vikurva/SkinBot/Mechanical/CAD Robot V1/suction_cup_vertical_v8_rotator_assembly.SLDASM

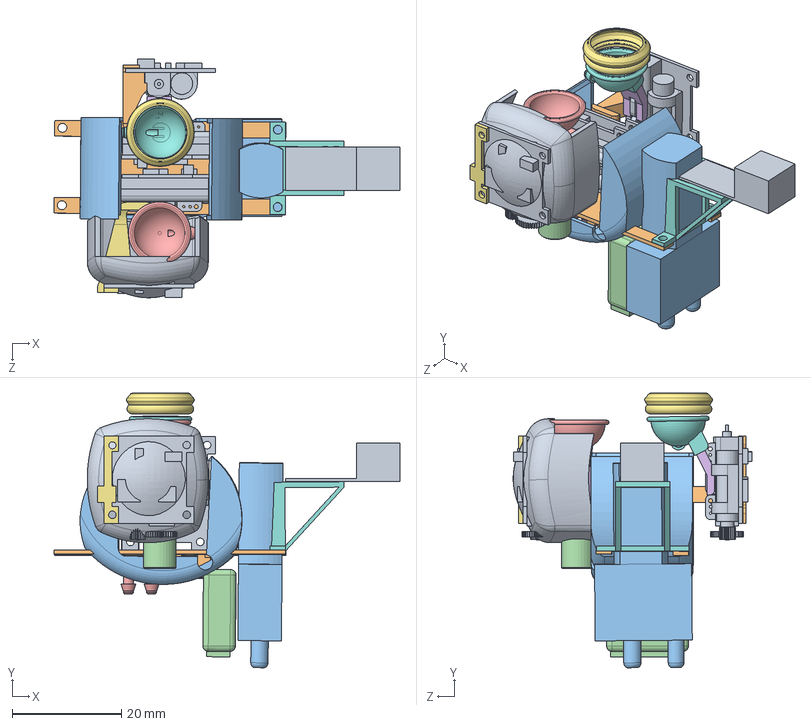
[picture p1: CAD file, 2018-07-06]
Mechanical/CAD Robot V1/suction_cup_vertical_v8_rotator_assembly.SLDASM
63.4 x 50.3 x 43.7 mm
1_8grams_linear_servo x 4
servo_suction_cup_arm_right_v6
silicone_hoses_holder_v2
suction_cap_arm_v1
suction_cap_v1
PCB_SkinBot_tethered_v1
TGPP06-D-136
suction_cap_v1_for_motor_0_5_offset
motor_connector_v1
servo_suction_cup_arm_left_v6_motor
