vikurva/SkinBot/Electrical/tetherRobot_board/PCB_skinBot_tether_wire_board_v1.step

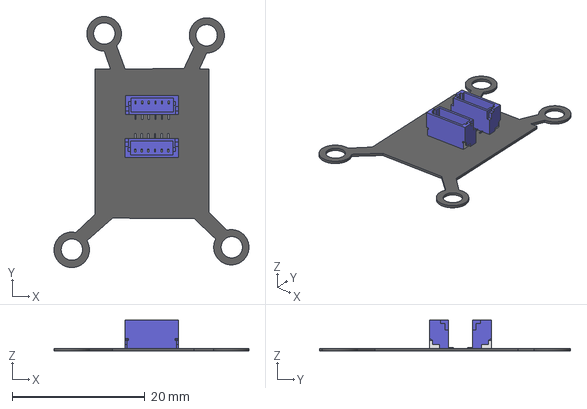
[picture p2: CAD file, 2018-07-12]
Electrical/tetherRobot_board/PCB_skinBot_tether_wire_board_v1.step
29.3 x 37.8 x 4.66 mm
