vikurva/SkinBot/Mechanical/CAD Robot V1/all parts 3D print V1/suction_cap_arm_v1.STL

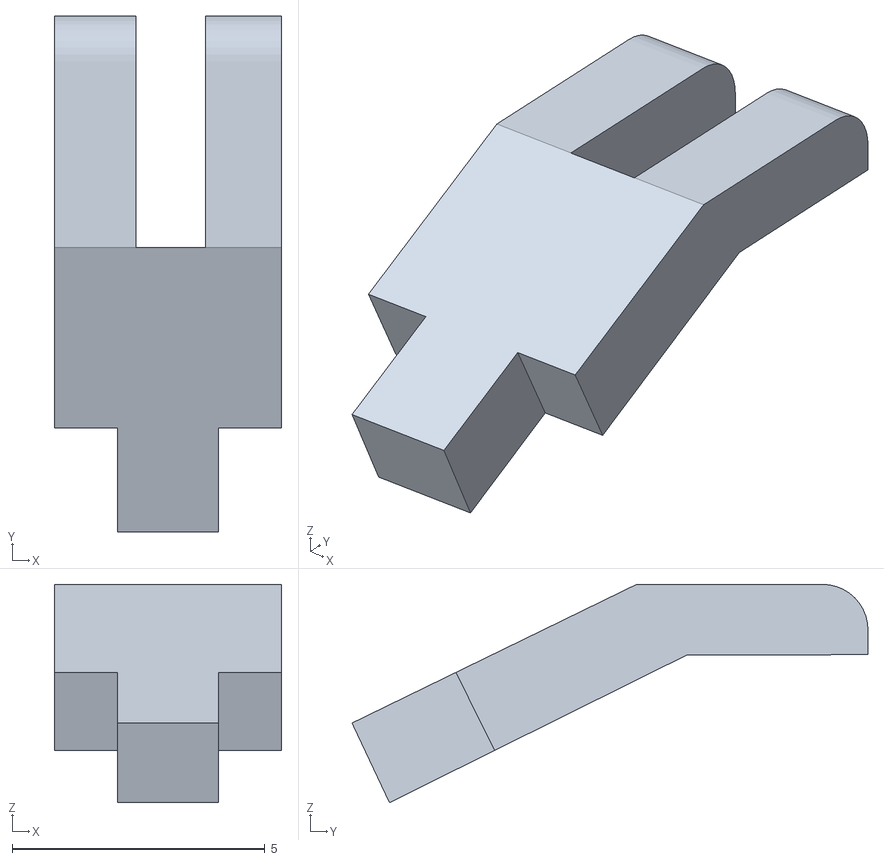
[picture p3: CAD file, 2018-07-06]
Mechanical/CAD Robot V1/all parts 3D print V1/suction_cap_arm_v1.STL
4.50 x 10.2 x 4.32
