vikurva/SkinBot/Mechanical/CAD Robot V1/nozzle_adapter_v1.SLDPRT

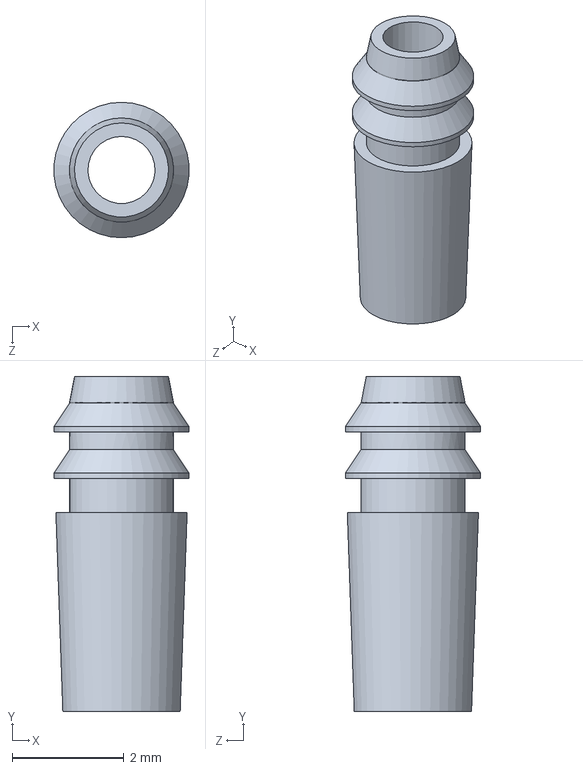
[picture p4: CAD file, 2018-07-06]
Mechanical/CAD Robot V1/nozzle_adapter_v1.SLDPRT
2.41 x 5.99 x 2.42 mm
