vikurva/SkinBot/Mechanical/CAD Robot V1/all parts 3D print V1/servo_suction_cup_arm_right_v6.STL

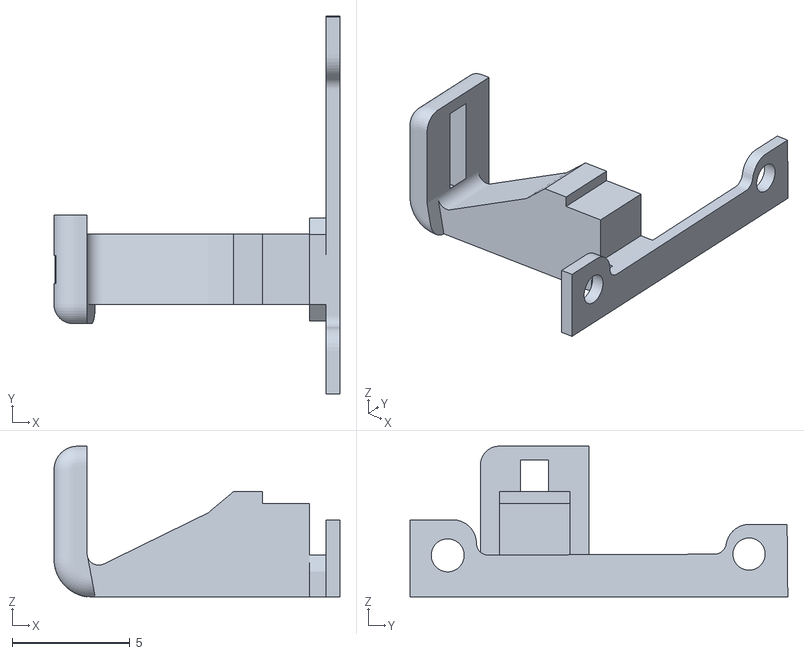
[picture p5: CAD file, 2018-07-06]
Mechanical/CAD Robot V1/all parts 3D print V1/servo_suction_cup_arm_right_v6.STL
12.1 x 16.0 x 6.40
