vikurva/SkinBot/Mechanical/CAD Robot V1/suction_cap_v1.SLDPRT

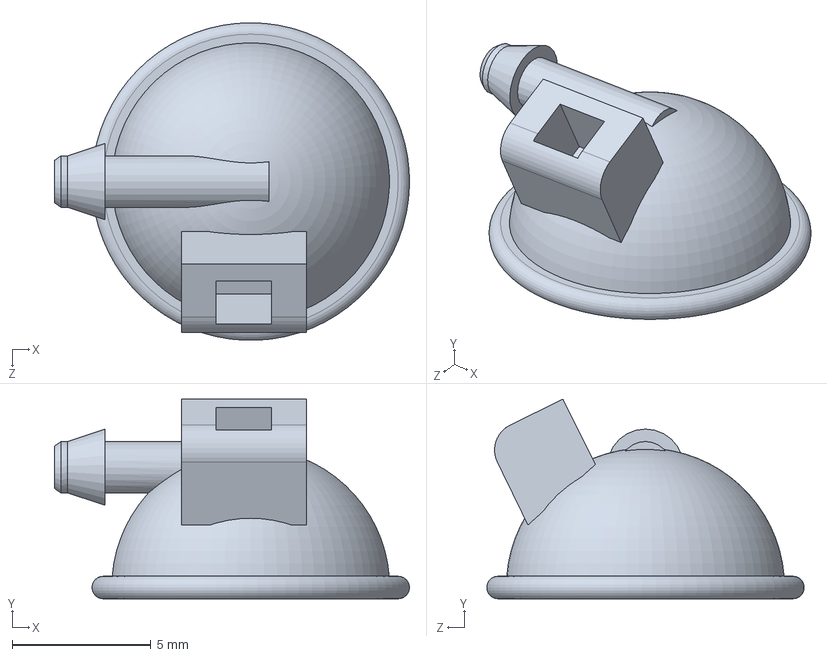
[picture p6: CAD file, 2018-07-06]
Mechanical/CAD Robot V1/suction_cap_v1.SLDPRT
12.8 x 7.19 x 11.4 mm
