vikurva/SkinBot/Mechanical/CAD Robot V1/all parts 3D print V1/servo_suction_cup_arm_left_v6_motor.STL

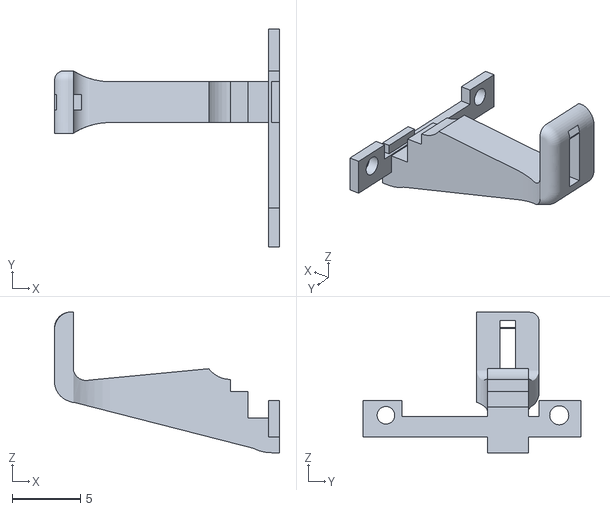
[picture p7: CAD file, 2018-07-06]
Mechanical/CAD Robot V1/all parts 3D print V1/servo_suction_cup_arm_left_v6_motor.STL
16.5 x 16.0 x 10.3
