vikurva/SkinBot/Mechanical/CAD Robot V1/rubber_sleeve_v1.SLDPRT

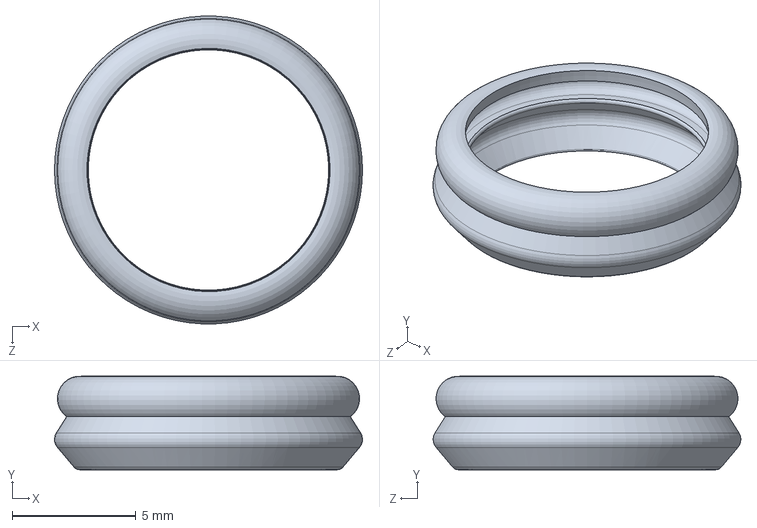
[picture p8: CAD file, 2018-07-06]
Mechanical/CAD Robot V1/rubber_sleeve_v1.SLDPRT
12.5 x 3.78 x 12.4 mm
