vikurva/SkinBot/Mechanical/CAD Robot V1/all parts 3D print V1/suction_cap_v1_for_motor_0_5_offset.STL

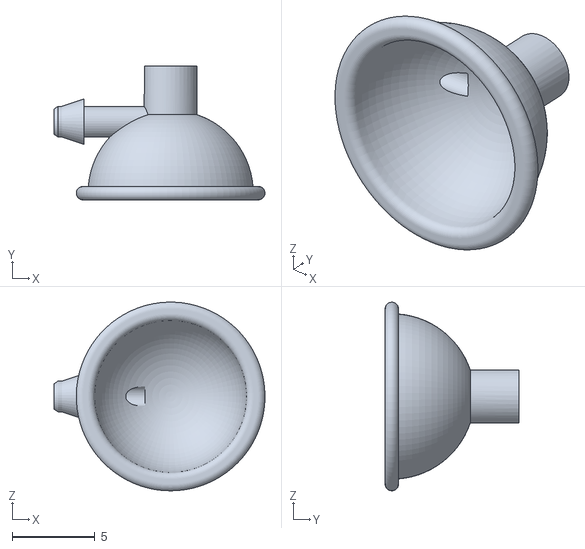
[picture p9: CAD file, 2018-07-06]
Mechanical/CAD Robot V1/all parts 3D print V1/suction_cap_v1_for_motor_0_5_offset.STL
12.8 x 8.11 x 11.4
