vikurva/SkinBot/Mechanical/CAD Robot V1/servo_suction_cup_holder_v1.SLDPRT

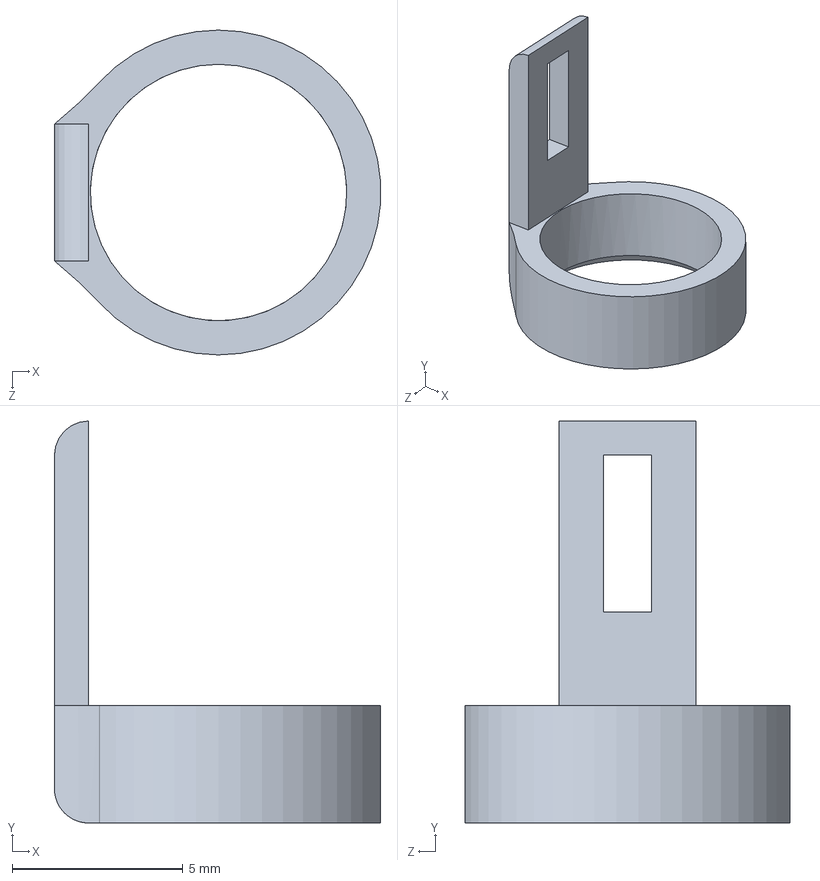
[picture p10: CAD file, 2018-07-06]
Mechanical/CAD Robot V1/servo_suction_cup_holder_v1.SLDPRT
9.54 x 11.8 x 9.50 mm
