vikurva/SkinBot/Mechanical/CAD Robot V1/all parts 3D print V1/silicone_hoses_holder_v2.STL

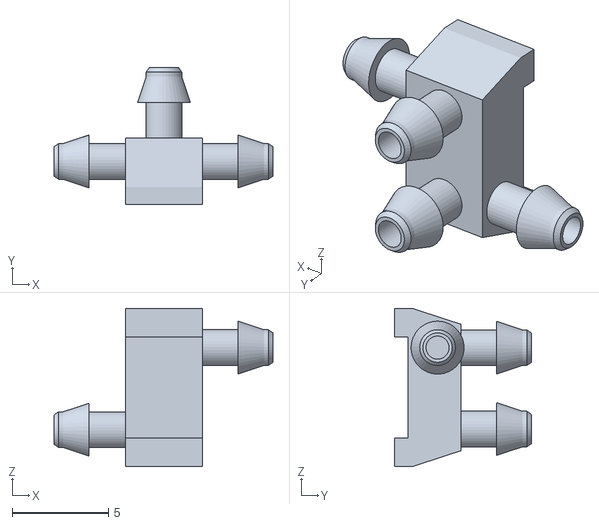
[picture p11: CAD file, 2018-07-06]
Mechanical/CAD Robot V1/all parts 3D print V1/silicone_hoses_holder_v2.STL
11.4 x 7.12 x 8.25
