vikurva/SkinBot/Mechanical/CAD Robot V1/PCB_SkinBot_tethered_v1.SLDPRT

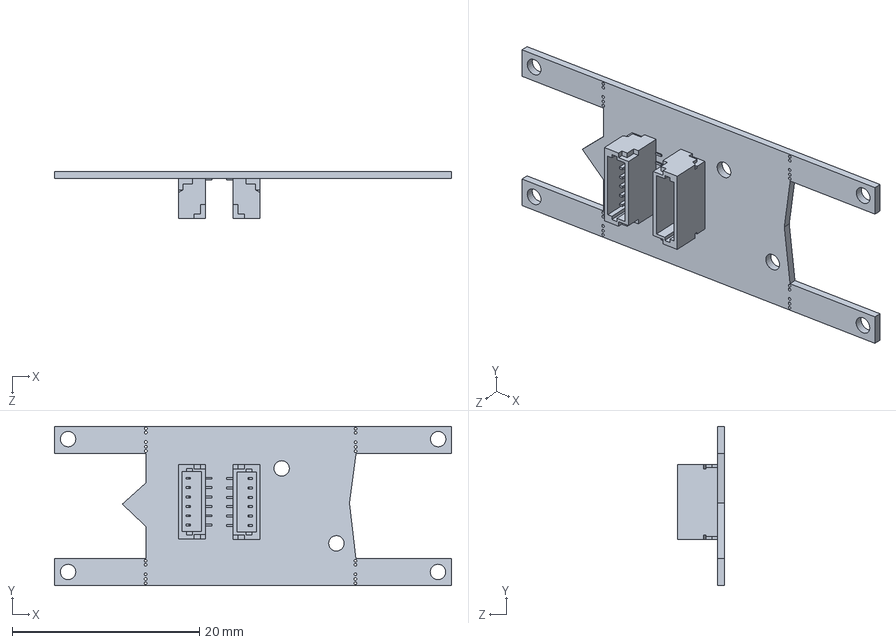
[picture p12: CAD file, 2018-07-06]
Mechanical/CAD Robot V1/PCB_SkinBot_tethered_v1.SLDPRT
42.4 x 17.0 x 5.02 mm
