vikurva/SkinBot/Mechanical/CAD Robot V1/motor_connector_v1.SLDPRT

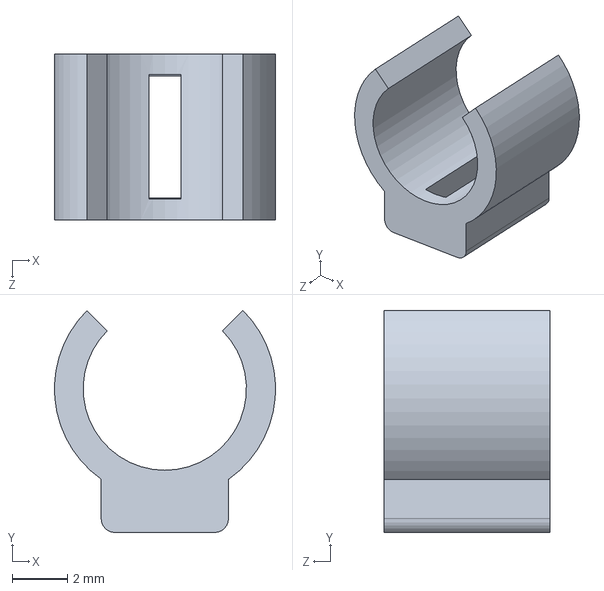
[picture p13: CAD file, 2018-07-06]
Mechanical/CAD Robot V1/motor_connector_v1.SLDPRT
7.99 x 8.03 x 6.00 mm
