vikurva/SkinBot/Mechanical/CAD Robot V1/camera_mount_v1.SLDPRT

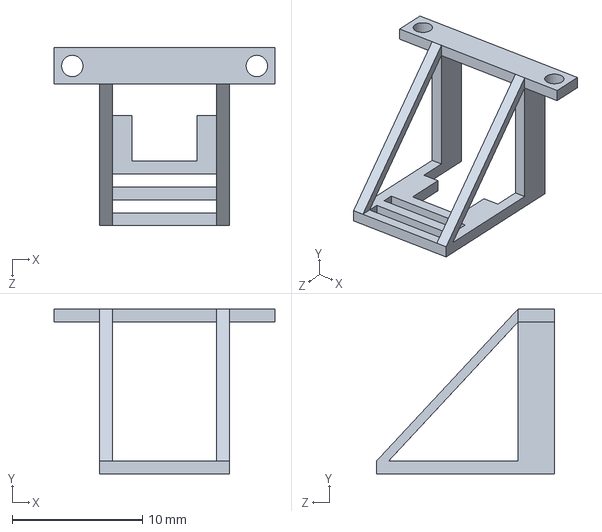
[picture p14: CAD file, 2018-07-06]
Mechanical/CAD Robot V1/camera_mount_v1.SLDPRT
17.0 x 12.6 x 13.7 mm
