vikurva/SkinBot/Mechanical/CAD Robot V1/small_DC_pumP_30kPa.SLDPRT

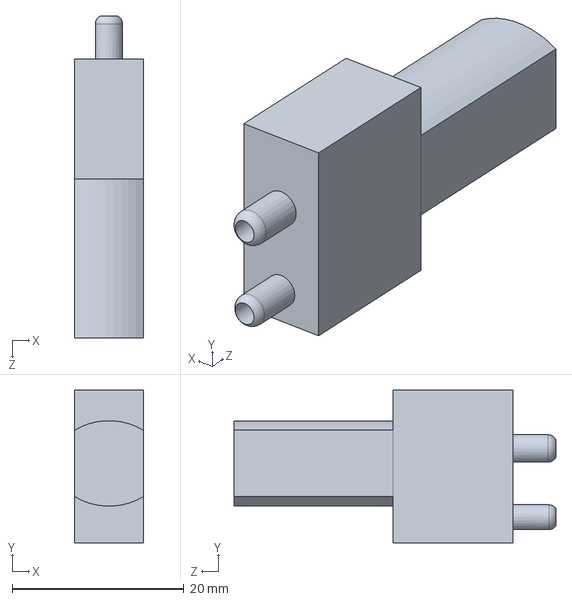
[picture p15: CAD file, 2018-07-06]
Mechanical/CAD Robot V1/small_DC_pumP_30kPa.SLDPRT
8.00 x 17.8 x 37.5 mm
