vikurva/SkinBot/Mechanical/CAD Robot V1/silicone_hoses_holder_v2_inverse.SLDPRT

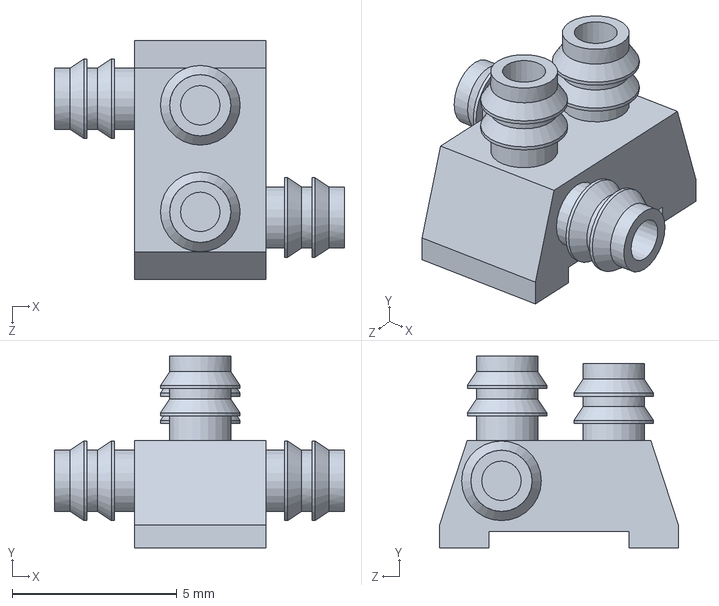
[picture p16: CAD file, 2018-07-06]
Mechanical/CAD Robot V1/silicone_hoses_holder_v2_inverse.SLDPRT
8.80 x 5.82 x 7.25 mm
