vikurva/SkinBot/Mechanical/CAD Robot V1/TGPP06-D-136.SLDPRT

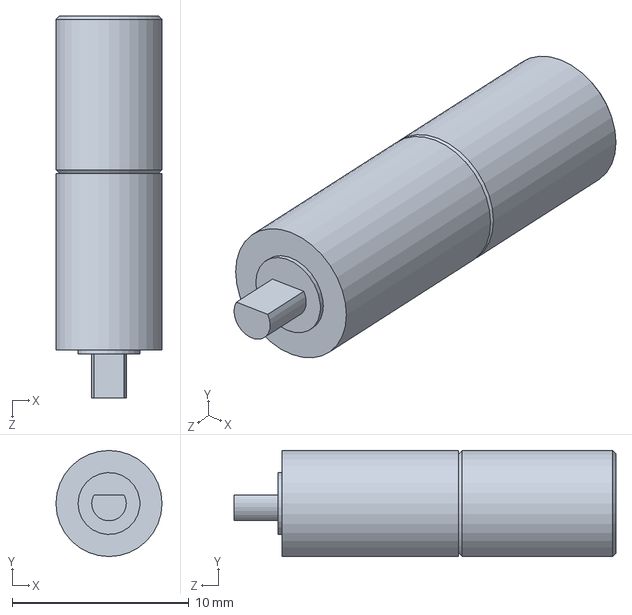
[picture p17: CAD file, 2018-07-06]
Mechanical/CAD Robot V1/TGPP06-D-136.SLDPRT
6.00 x 6.00 x 21.6 mm
