vikurva/SkinBot/Mechanical/CAD Robot V1/100mAh_battery_quadcopter.SLDPRT

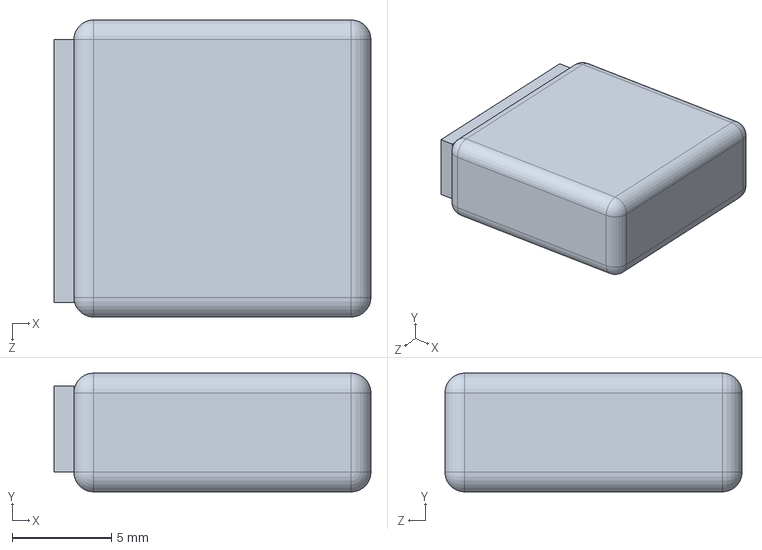
[picture p18: CAD file, 2018-07-06]
Mechanical/CAD Robot V1/100mAh_battery_quadcopter.SLDPRT
16.0 x 6.00 x 15.0 mm
