vikurva/SkinBot/Mechanical/CAD Robot V1/silicone_hose_v1.SLDPRT

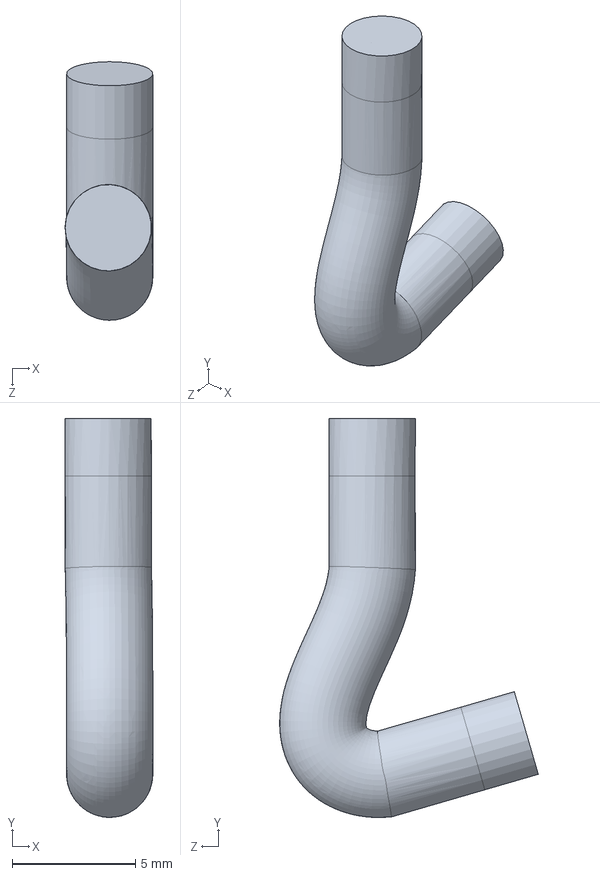
[picture p19: CAD file, 2018-07-06]
Mechanical/CAD Robot V1/silicone_hose_v1.SLDPRT
3.56 x 16.2 x 10.5 mm
