vikurva/SkinBot/Mechanical/CAD Robot V1/casing_arm.SLDPRT

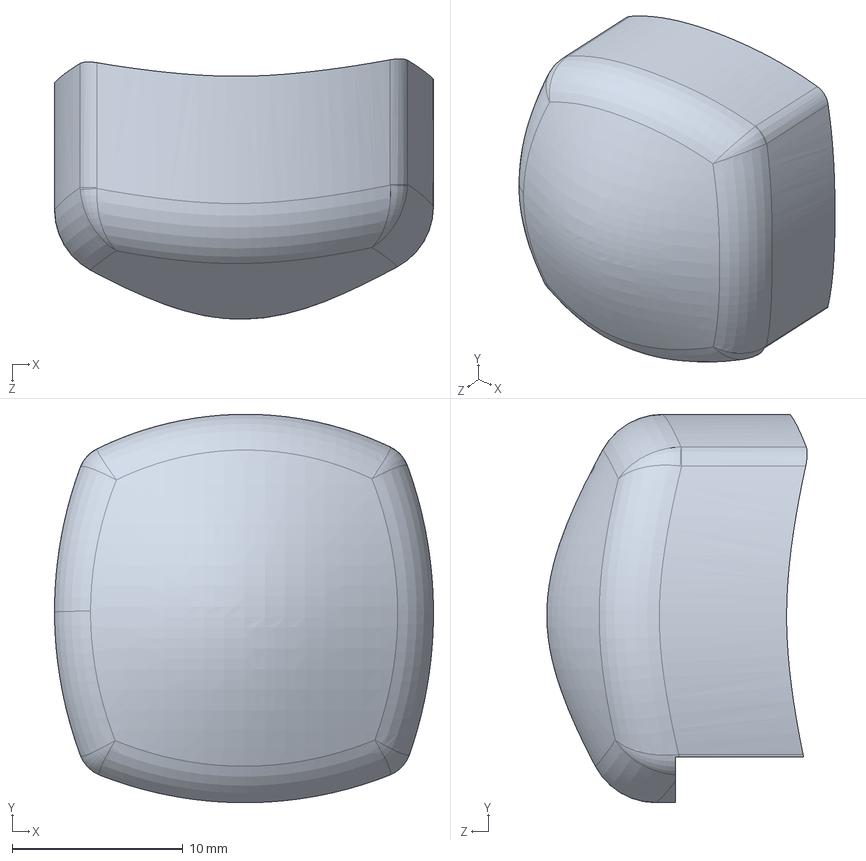
[picture p20: CAD file, 2018-07-06]
Mechanical/CAD Robot V1/casing_arm.SLDPRT
22.2 x 22.7 x 15.2 mm
