vikurva/SkinBot/Mechanical/CAD Robot V1/spy_cam_V1.SLDPRT

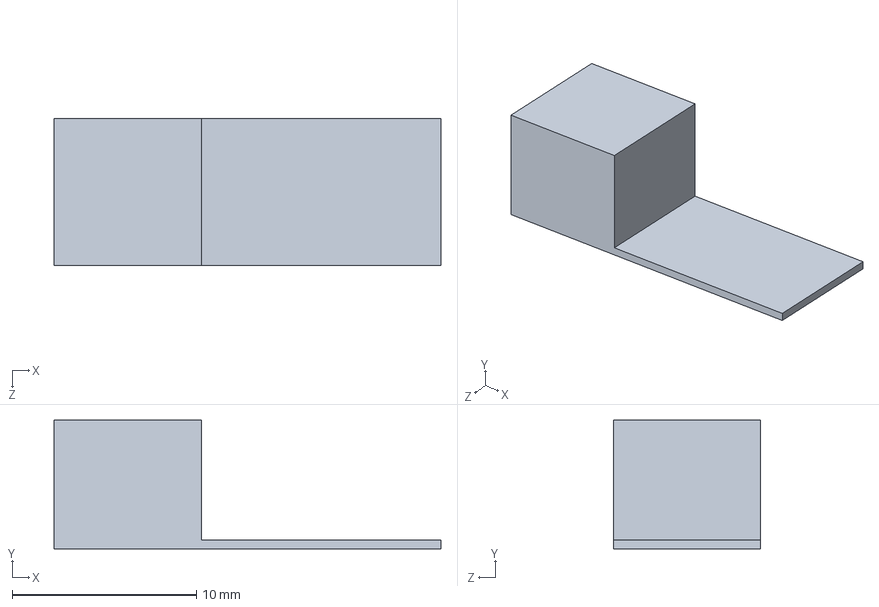
[picture p21: CAD file, 2018-07-06]
Mechanical/CAD Robot V1/spy_cam_V1.SLDPRT
21.0 x 7.00 x 8.00 mm
