vikurva/SkinBot/Mechanical/CAD Robot V1/servo_suction_cup_arm_left_v5.SLDPRT

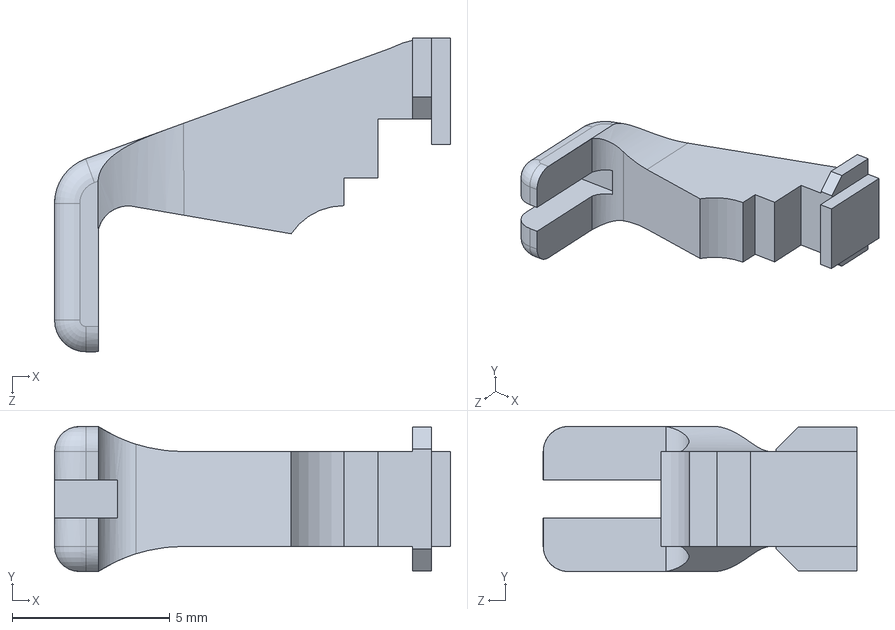
[picture p22: CAD file, 2018-07-06]
Mechanical/CAD Robot V1/servo_suction_cup_arm_left_v5.SLDPRT
12.5 x 4.60 x 9.93 mm
