vikurva/SkinBot/Mechanical/CAD Robot V1/casing_body_v1.SLDPRT

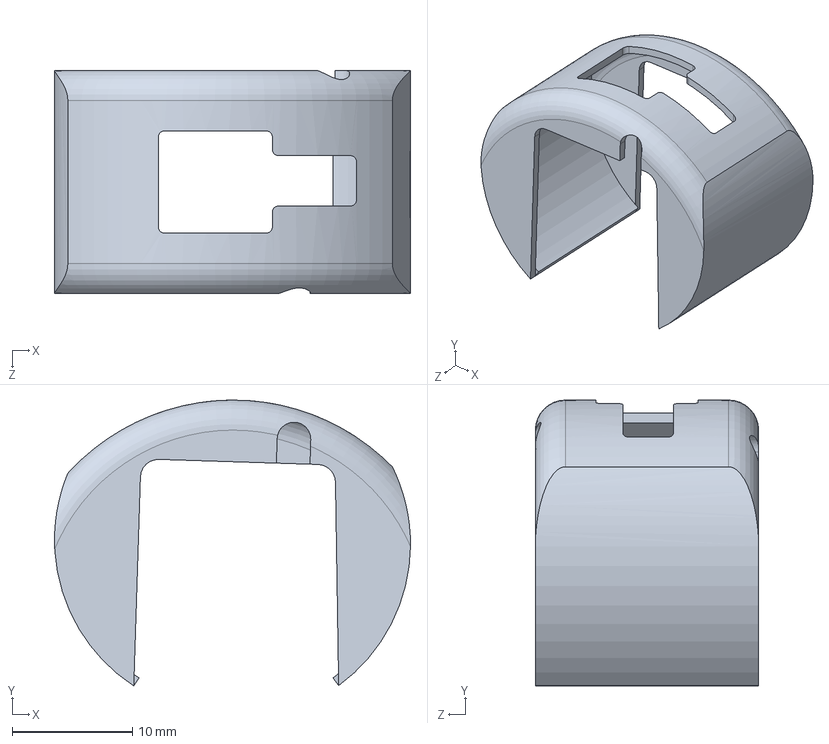
[picture p23: CAD file, 2018-07-06]
Mechanical/CAD Robot V1/casing_body_v1.SLDPRT
29.6 x 23.8 x 18.6 mm
