vikurva/SkinBot/(list of files, cad)

Other CAD files:
Mechanical/CAD Robot V1/all parts 3D print V1/suction_cap_v1.STL
Mechanical/CAD Robot V1/suction_cap_v1_for_motor_0_5_offset.SLDPRT
Mechanical/CAD Robot V1/suction_cap_arm_v1.SLDPRT
Mechanical/CAD Robot V1/servo_suction_cup_arm_right_v6.SLDPRT
Mechanical/CAD Robot V1/servo_suction_cup_arm_left_v6_motor.SLDPRT
Mechanical/CAD Robot V1/silicone_hoses_holder_v2.SLDPRT
Mechanical/CAD Robot V1/servo_suction_cup_arm_left_v5_motor.SLDPRT
Mechanical/CAD Robot V1/servo_suction_cup_arm_right_v5.SLDPRT
