vikurva/SkinBot/Electrical/Main_board/Schematic_skinbot_master_v4.pdf

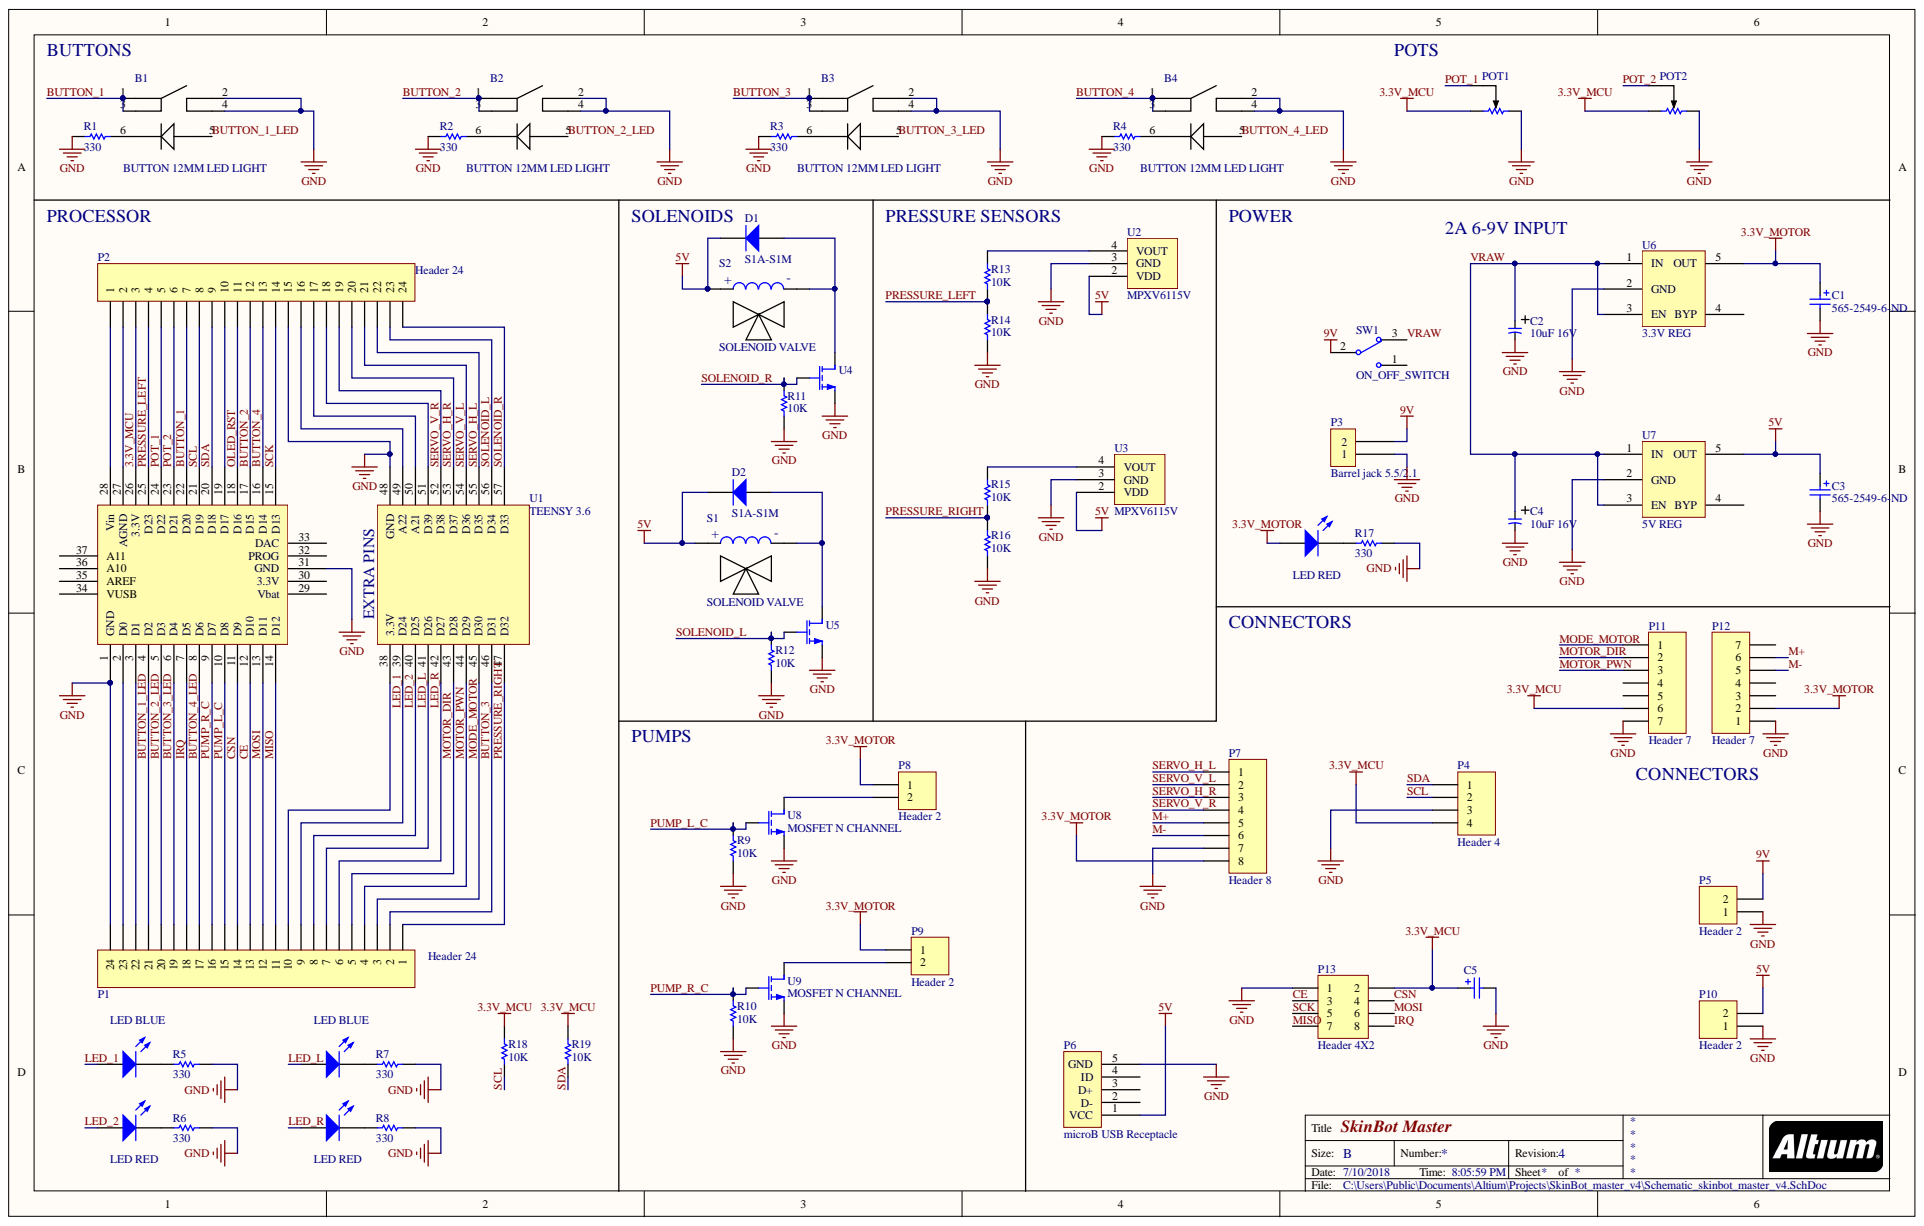
[picture p24: page 1]

C:\Users\Public\Documents\Altium\Projects\SkinBot_master_v4\Schematic_skinbot_master_v4.SchDoc
