vikurva/SkinBot/(list of files, drawings)

Other design files:
Electrical/Artem_Library.SchLib
Electrical/Main_board/PCB_skinBot_master_v4.PcbDoc
Electrical/Main_board/Schematic_skinbot_master_v4.SchDoc
Electrical/Main_board/SkinBot_master_v4.PrjPcb
Electrical/tetherRobot_board/PCB_skinBot_tether_wire_board_v1.PcbDoc
Electrical/tetherRobot_board/Schematic_skinBot_tether_wire_board_v1.SchDoc
Electrical/tetherRobot_board/SkinBot_tether_wire_board_v1.PrjPcb
