vikurva/SkinBot/(commit log)

2018-07-06 added cad robot v1
    [100mAh_battery_quadcopter.SLDPRT, PCB_SkinBot_tethered_v1.SLDPRT, TGPP06-D-136.SLDPRT, camera_mount_v1.SLDPRT, casing_arm.SLDPRT, casing_body_v1.SLDPRT, motor_connector_v1.SLDPRT, nozzle_adapter_v1.SLDPRT]
2018-07-06 added library
    [Artem_Library.SchLib]
2018-07-09 updated pcb files master
    [PCB_skinBot_master_v4.PcbDoc, Schematic_skinbot_master_v4.SchDoc, SkinBot_master_v4.PrjPcb]
2018-07-11 updated PCB files
    final PCB files ready
    [Schematic_skinbot_master_v4.SchDoc, SkinBot_master_v4.PrjPcb]
2018-07-11 updated connector
    [Schematic_skinbot_master_v4.SchDoc, SkinBot_master_v4.PrjPcb]
2018-07-12 added tether board
    [PCB_skinBot_tether_wire_board_v1.PcbDoc, Schematic_skinBot_tether_wire_board_v1.SchDoc, SkinBot_tether_wire_board_v1.PrjPcb]
2018-07-12 added holes to easy snap
    [PCB_skinBot_tether_wire_board_v1.PcbDoc]
2018-07-12 added fab files for tether board
    [PCB_skinBot_tether_wire_board_v1.PcbDoc, PCB_skinBot_tether_wire_board_v1.step, Schematic_skinBot_tether_wire_board_v1.SchDoc, SkinBot_tether_wire_board_v1.PrjPcb]
